axelo/custom-cpu/README.md

# custom-cpu

A custom CPU built from 7400-series integrated circuits.
