axelo/custom-cpu/kicad/custom-cpu.kicad_pcb

## KiCad design kicad/custom-cpu.kicad_pcb (2024-03-03)

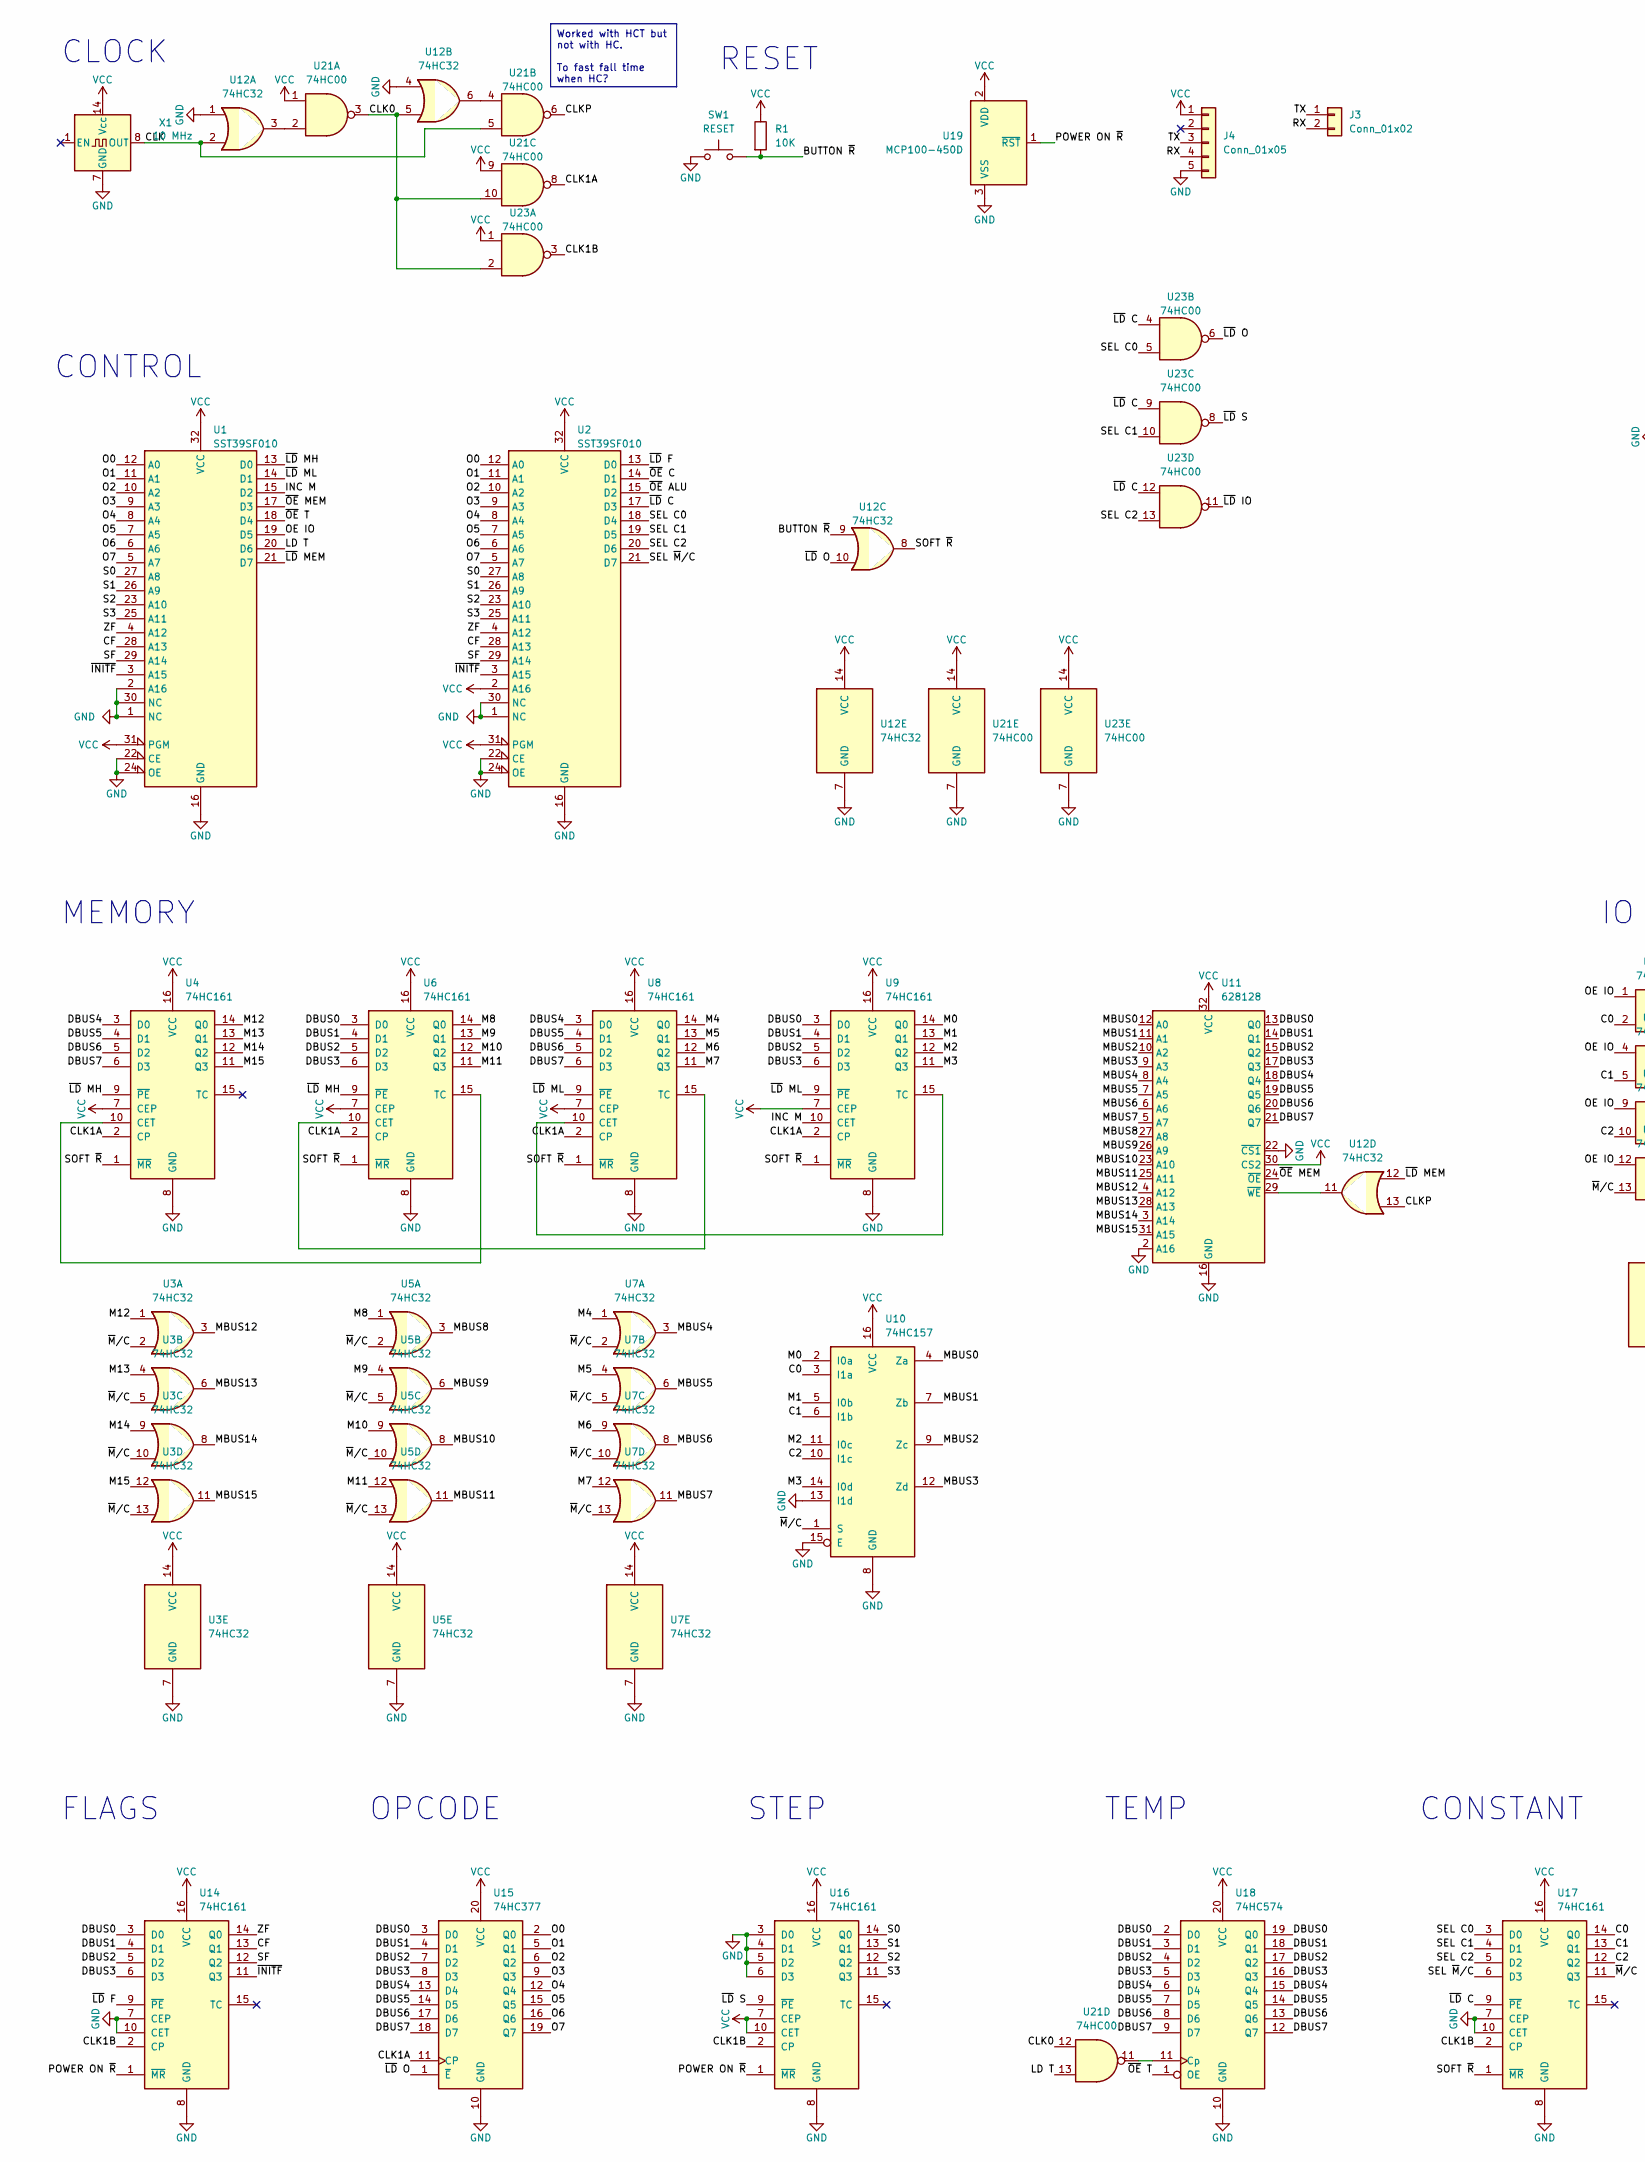
[picture p1: schematic custom-cpu.kicad_sch, part in row 1, column 1]

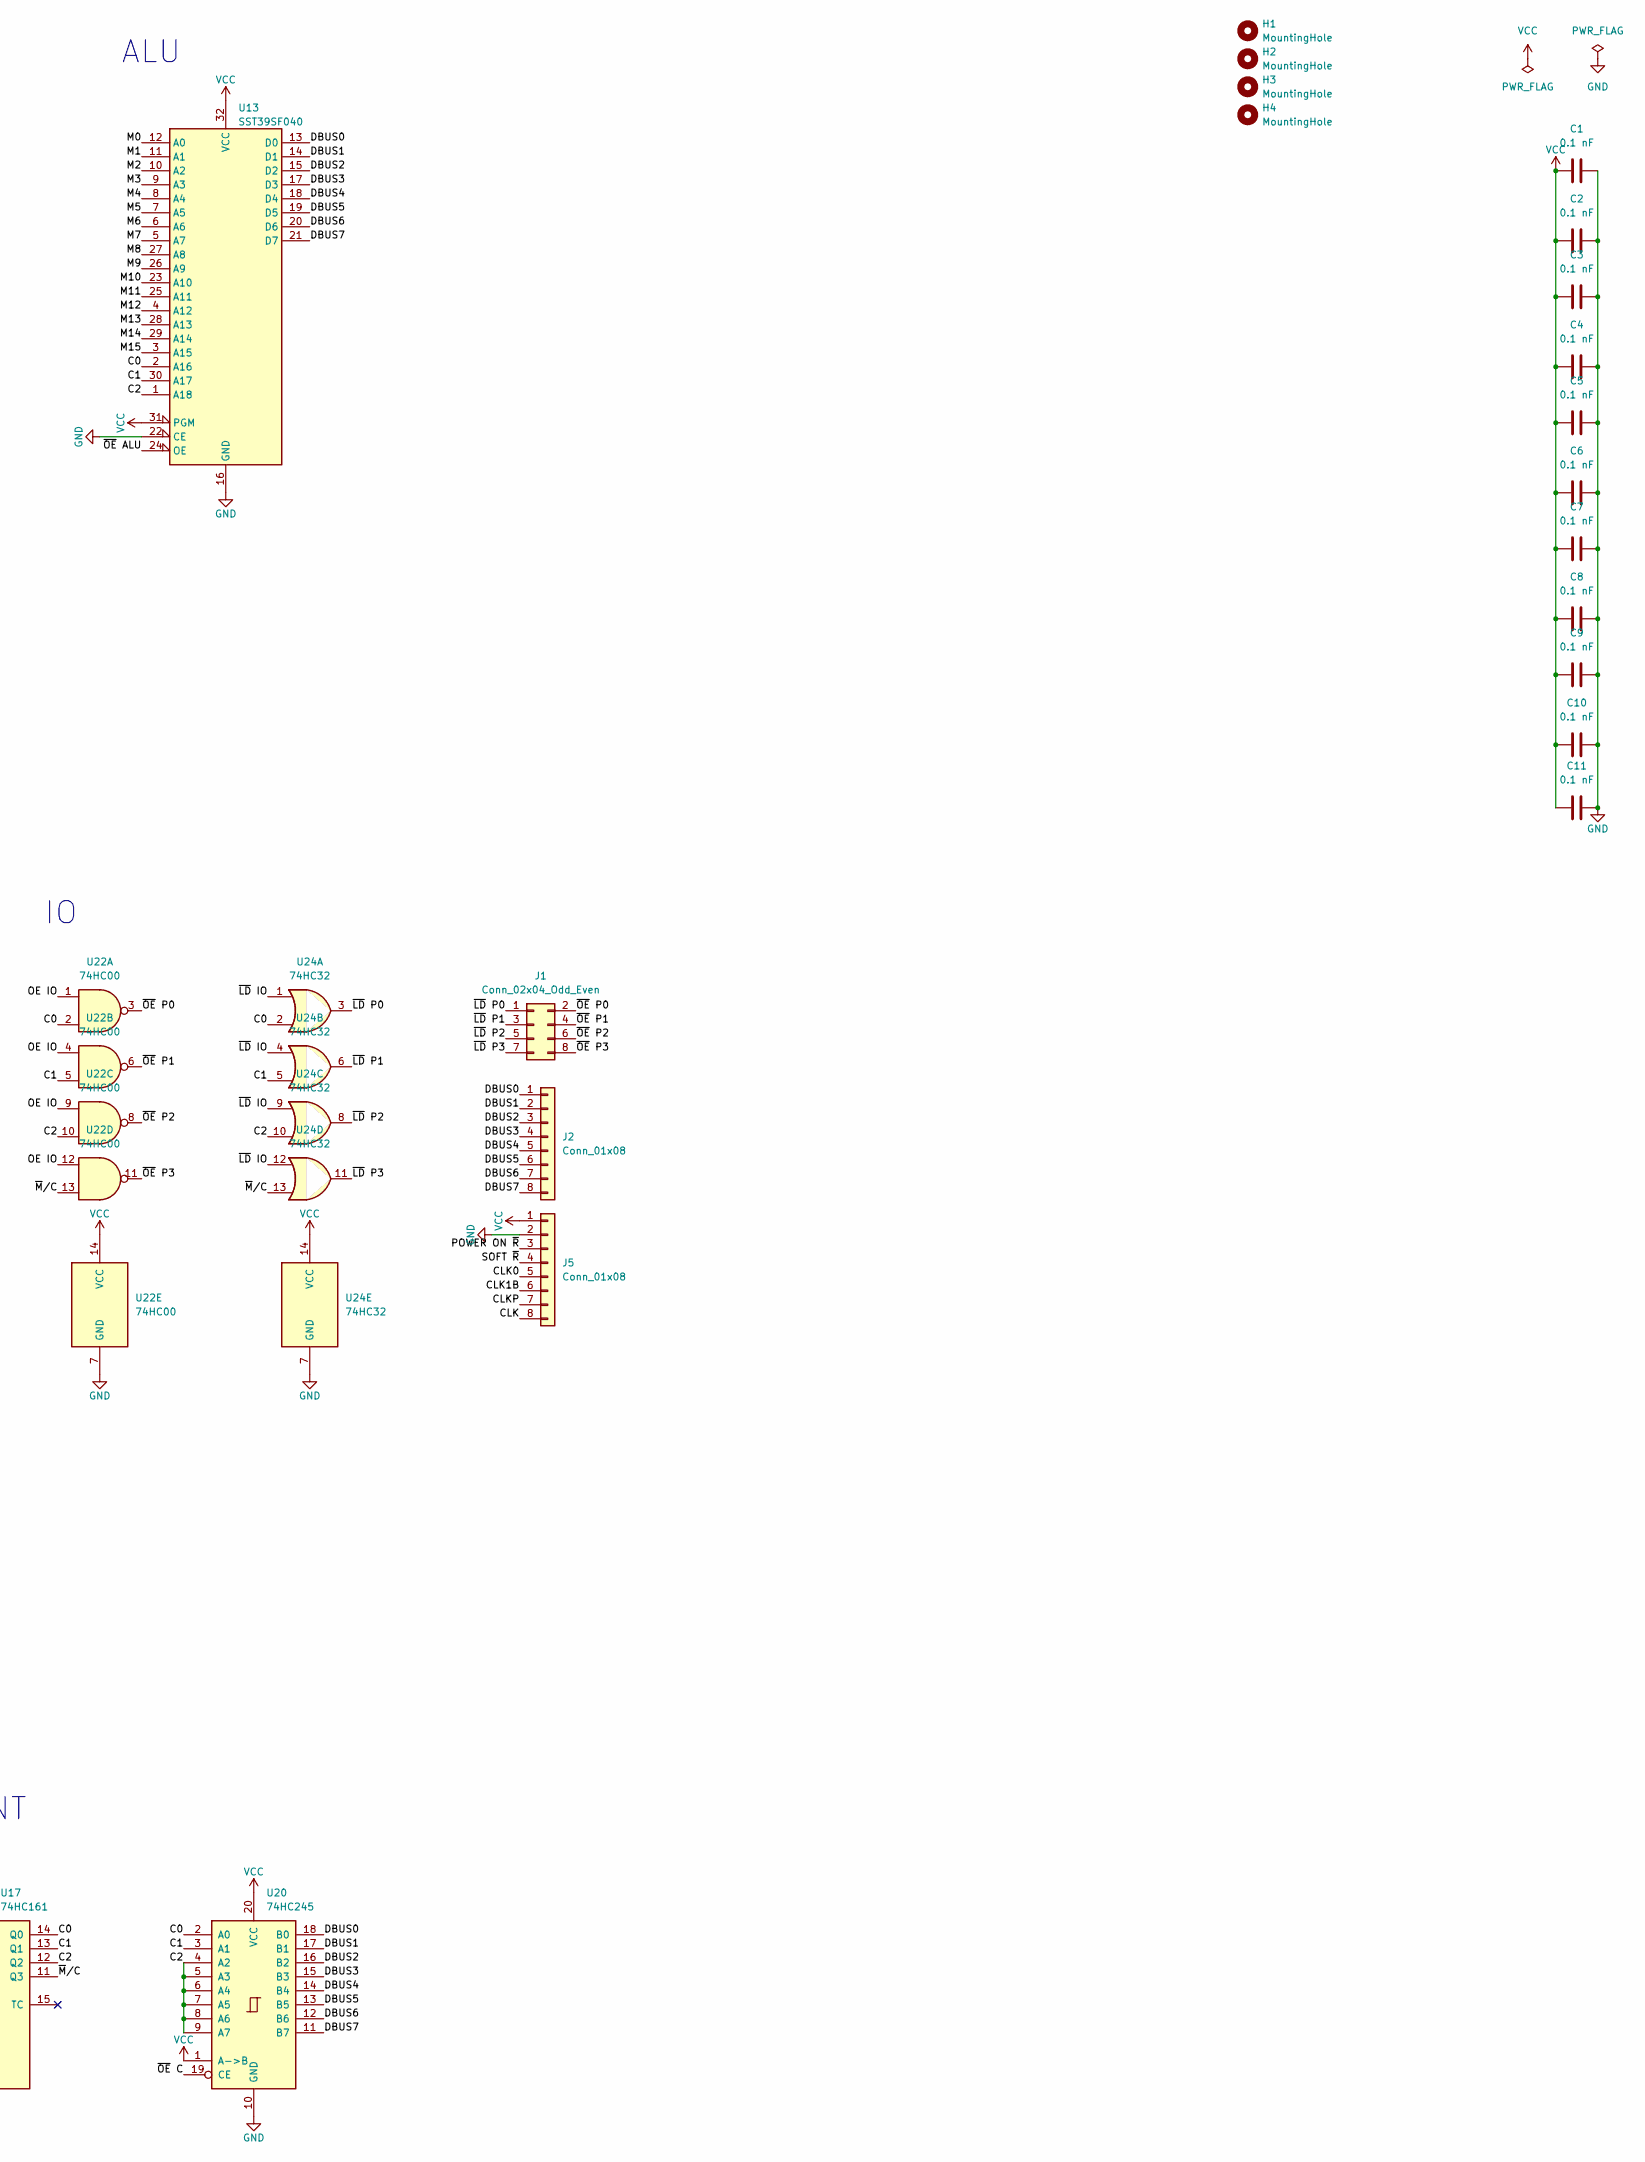
[picture p2: schematic custom-cpu.kicad_sch, part in row 1, column 2]

Parts:
C1, C2, C3, C4, C5, C6, C7, C8, C9, C10, C11: 0.1 nF; C_Disc_D5.0mm_W2.5mm_P5.00mm
H1, H2, H3, H4: MountingHole; MountingHole_3.2mm_M3
J1: Conn_02x04_Odd_Even; PinSocket_2x04_P2.54mm_Vertical
J2, J5: Conn_01x08; PinSocket_1x08_P2.54mm_Vertical
J3: Conn_01x02; PinSocket_1x02_P2.54mm_Vertical
J4: Conn_01x05; PinSocket_1x05_P2.54mm_Vertical
R1: 10K; R_Axial_DIN0207_L6.3mm_D2.5mm_P7.62mm_Horizontal
SW1: RESET; SW_PUSH_6mm
U1, U2: SST39SF010; DIP-32_W15.24mm_Socket
U3, U5, U7, U12, U24: 74HC32; DIP-14_W7.62mm_Socket
U4, U6, U8, U9, U14, U16, U17: 74HC161; DIP-16_W7.62mm_Socket
U10: 74HC157; DIP-16_W7.62mm_Socket
U11: 628128; DIP-32_W15.24mm_Socket
U13: SST39SF040; DIP-32_W15.24mm_Socket
U15: 74HC377; DIP-20_W7.62mm_Socket
U18: 74HC574; DIP-20_W7.62mm_Socket
U19: MCP100-450D; PinHeader_1x03_P2.00mm_Vertical
U20: 74HC245; DIP-20_W7.62mm_Socket
U21, U22, U23: 74HC00; DIP-14_W7.62mm_Socket
X1: 10 MHz; Oscillator_DIP-14

Connections:
/BUTTON ~R: R1.2, SW1.2, U12.9
/C0: U10.3 (I1a), U13.2 (A16), U17.14 (Q0), U20.2 (A0), U22.2, U24.2
/C1: U10.6 (I1b), U13.30 (A17), U17.13 (Q1), U20.3 (A1), U22.5, U24.5
/C2: U10.10 (I1c), U13.1 (A18), U17.12 (Q2), U20.4 (A2), U20.5 (A3), U20.6 (A4), U20.7 (A5), U20.8 (A6), U20.9 (A7), U22.10, U24.10
/CF: U1.28 (A13), U2.28 (A13), U14.13 (Q1)
/CLK: J5.8, U12.2, U21.5, X1.8 (OUT)
/CLK0: J5.5, U12.5, U21.3, U21.10, U21.12, U23.2
/CLK1A: U4.2 (CP), U6.2 (CP), U8.2 (CP), U9.2 (CP), U15.11 (CP), U21.8
/CLK1B: J5.6, U14.2 (CP), U16.2 (CP), U17.2 (CP), U23.3
/CLKP: J5.7, U12.13, U21.6
/DBUS0: J2.1, U6.3 (D0), U9.3 (D0), U11.13 (Q0), U13.13 (D0), U14.3 (D0), U15.3 (D0), U18.2 (D0), U18.19 (Q0), U20.18 (B0)
/DBUS1: J2.2, U6.4 (D1), U9.4 (D1), U11.14 (Q1), U13.14 (D1), U14.4 (D1), U15.4 (D1), U18.3 (D1), U18.18 (Q1), U20.17 (B1)
/DBUS2: J2.3, U6.5 (D2), U9.5 (D2), U11.15 (Q2), U13.15 (D2), U14.5 (D2), U15.7 (D2), U18.4 (D2), U18.17 (Q2), U20.16 (B2)
/DBUS3: J2.4, U6.6 (D3), U9.6 (D3), U11.17 (Q3), U13.17 (D3), U14.6 (D3), U15.8 (D3), U18.5 (D3), U18.16 (Q3), U20.15 (B3)
/DBUS4: J2.5, U4.3 (D0), U8.3 (D0), U11.18 (Q4), U13.18 (D4), U15.13 (D4), U18.6 (D4), U18.15 (Q4), U20.14 (B4)
/DBUS5: J2.6, U4.4 (D1), U8.4 (D1), U11.19 (Q5), U13.19 (D5), U15.14 (D5), U18.7 (D5), U18.14 (Q5), U20.13 (B5)
/DBUS6: J2.7, U4.5 (D2), U8.5 (D2), U11.20 (Q6), U13.20 (D6), U15.17 (D6), U18.8 (D6), U18.13 (Q6), U20.12 (B6)
/DBUS7: J2.8, U4.6 (D3), U8.6 (D3), U11.21 (Q7), U13.21 (D7), U15.18 (D7), U18.9 (D7), U18.12 (Q7), U20.11 (B7)
/INC M: U1.15 (D2), U9.10 (CET)
/LD T: U1.20 (D6), U21.13
/M0: U9.14 (Q0), U10.2 (I0a), U13.12 (A0)
/M1: U9.13 (Q1), U10.5 (I0b), U13.11 (A1)
/M2: U9.12 (Q2), U10.11 (I0c), U13.10 (A2)
/M3: U9.11 (Q3), U10.14 (I0d), U13.9 (A3)
/M4: U7.1, U8.14 (Q0), U13.8 (A4)
/M5: U7.4, U8.13 (Q1), U13.7 (A5)
/M6: U7.9, U8.12 (Q2), U13.6 (A6)
/M7: U7.12, U8.11 (Q3), U13.5 (A7)
/M8: U5.1, U6.14 (Q0), U13.27 (A8)
/M9: U5.4, U6.13 (Q1), U13.26 (A9)
/M10: U5.9, U6.12 (Q2), U13.23 (A10)
/M11: U5.12, U6.11 (Q3), U13.25 (A11)
/M12: U3.1, U4.14 (Q0), U13.4 (A12)
/M13: U3.4, U4.13 (Q1), U13.28 (A13)
/M14: U3.9, U4.12 (Q2), U13.29 (A14)
/M15: U3.12, U4.11 (Q3), U13.3 (A15)
/MBUS0: U10.4 (Za), U11.12 (A0)
/MBUS1: U10.7 (Zb), U11.11 (A1)
/MBUS2: U10.9 (Zc), U11.10 (A2)
/MBUS3: U10.12 (Zd), U11.9 (A3)
/MBUS4: U7.3, U11.8 (A4)
/MBUS5: U7.6, U11.7 (A5)
/MBUS6: U7.8, U11.6 (A6)
/MBUS7: U7.11, U11.5 (A7)
/MBUS8: U5.3, U11.27 (A8)
/MBUS9: U5.6, U11.26 (A9)
/MBUS10: U5.8, U11.23 (A10)
/MBUS11: U5.11, U11.25 (A11)
/MBUS12: U3.3, U11.4 (A12)
/MBUS13: U3.6, U11.28 (A13)
/MBUS14: U3.8, U11.3 (A14)
/MBUS15: U3.11, U11.31 (A15)
/O0: U1.12 (A0), U2.12 (A0), U15.2 (Q0)
/O1: U1.11 (A1), U2.11 (A1), U15.5 (Q1)
/O2: U1.10 (A2), U2.10 (A2), U15.6 (Q2)
/O3: U1.9 (A3), U2.9 (A3), U15.9 (Q3)
/O4: U1.8 (A4), U2.8 (A4), U15.12 (Q4)
/O5: U1.7 (A5), U2.7 (A5), U15.15 (Q5)
/O6: U1.6 (A6), U2.6 (A6), U15.16 (Q6)
/O7: U1.5 (A7), U2.5 (A7), U15.19 (Q7)
/OE IO: U1.19 (D5), U22.1, U22.4, U22.9, U22.12
/POWER ON ~R: J5.3, U14.1 (~MR), U16.1 (~MR), U19.1 (~RST)
/RX: J3.2, J4.4
/S0: U1.27 (A8), U2.27 (A8), U16.14 (Q0)
/S1: U1.26 (A9), U2.26 (A9), U16.13 (Q1)
/S2: U1.23 (A10), U2.23 (A10), U16.12 (Q2)
/S3: U1.25 (A11), U2.25 (A11), U16.11 (Q3)
/SEL C0: U2.18 (D4), U17.3 (D0), U23.5
/SEL C1: U2.19 (D5), U17.4 (D1), U23.10
/SEL C2: U2.20 (D6), U17.5 (D2), U23.13
/SEL ~M/C: U2.21 (D7), U17.6 (D3)
/SF: U1.29 (A14), U2.29 (A14), U14.12 (Q2)
/SOFT ~R: J5.4, U4.1 (~MR), U6.1 (~MR), U8.1 (~MR), U9.1 (~MR), U12.8, U17.1 (~MR)
/TX: J3.1, J4.3
/ZF: U1.4 (A12), U2.4 (A12), U14.14 (Q0)
/~INITF: U1.3 (A15), U2.3 (A15), U14.11 (Q3)
/~LD C: U2.17 (D3), U17.9 (~PE), U23.4, U23.9, U23.12
/~LD F: U2.13 (D0), U14.9 (~PE)
/~LD IO: U23.11, U24.1, U24.4, U24.9, U24.12
/~LD MEM: U1.21 (D7), U12.12
/~LD MH: U1.13 (D0), U4.9 (~PE), U6.9 (~PE)
/~LD ML: U1.14 (D1), U8.9 (~PE), U9.9 (~PE)
/~LD O: U12.10, U15.1 (~E), U23.6
/~LD P0: J1.1, U24.3
/~LD P1: J1.3, U24.6
/~LD P2: J1.5, U24.8
/~LD P3: J1.7, U24.11
/~LD S: U16.9 (~PE), U23.8
/~M/C: U3.2, U3.5, U3.10, U3.13, U5.2, U5.5, U5.10, U5.13, U7.2, U7.5, U7.10, U7.13, U10.1 (S), U17.11 (Q3), U22.13, U24.13
/~OE ALU: U2.15 (D2), U13.24 (OE)
/~OE C: U2.14 (D1), U20.19 (CE)
/~OE MEM: U1.17 (D3), U11.24 (~OE)
/~OE P0: J1.2, U22.3
/~OE P1: J1.4, U22.6
/~OE P2: J1.6, U22.8
/~OE P3: J1.8, U22.11
/~OE T: U1.18 (D4), U18.1 (OE)
GND: C1.2, C2.2, C3.2, C4.2, C5.2, C6.2, C7.2, C8.2, C9.2, C10.2, C11.2, J4.5, J5.2, SW1.1, U1.1 (NC), U1.2 (A16), U1.16 (GND), U1.22 (CE), U1.24 (OE), U1.30 (NC), U2.1 (NC), U2.16 (GND), U2.22 (CE), U2.24 (OE), U2.30 (NC), U3.7 (GND), U4.8 (GND), U5.7 (GND), U6.8 (GND), U7.7 (GND), U8.8 (GND), U9.8 (GND), U10.8 (GND), U10.13 (I1d), U10.15 (E), U11.2 (A16), U11.16 (GND), U11.22 (~CS1), U12.1, U12.4, U12.7 (GND), U13.16 (GND), U13.22 (CE), U14.7 (CEP), U14.8 (GND), U14.10 (CET), U15.10 (GND), U16.3 (D0), U16.4 (D1), U16.5 (D2), U16.6 (D3), U16.8 (GND), U17.7 (CEP), U17.8 (GND), U17.10 (CET), U18.10 (GND), U19.3 (VSS), U20.10 (GND), U21.7 (GND), U22.7 (GND), U23.7 (GND), U24.7 (GND), X1.7 (GND)
unnamed: U4.10 (CET), U6.15 (TC)
unnamed: U6.10 (CET), U8.15 (TC)
unnamed: U8.10 (CET), U9.15 (TC)
unnamed: U11.29 (~WE), U12.11
unnamed: U12.3, U21.2
unnamed: U12.6, U21.4
unnamed: U18.11 (Cp), U21.11
VCC: C1.1, C2.1, C3.1, C4.1, C5.1, C6.1, C7.1, C8.1, C9.1, C10.1, C11.1, J4.1, J5.1, R1.1, U1.31 (PGM), U1.32 (VCC), U2.2 (A16), U2.31 (PGM), U2.32 (VCC), U3.14 (VCC), U4.7 (CEP), U4.16 (VCC), U5.14 (VCC), U6.7 (CEP), U6.16 (VCC), U7.14 (VCC), U8.7 (CEP), U8.16 (VCC), U9.7 (CEP), U9.16 (VCC), U10.16 (VCC), U11.30 (CS2), U11.32 (VCC), U12.14 (VCC), U13.31 (PGM), U13.32 (VCC), U14.16 (VCC), U15.20 (VCC), U16.7 (CEP), U16.10 (CET), U16.16 (VCC), U17.16 (VCC), U18.20 (VCC), U19.2 (VDD), U20.1 (A->B), U20.20 (VCC), U21.1, U21.9, U21.14 (VCC), U22.14 (VCC), U23.1, U23.14 (VCC), U24.14 (VCC), X1.14 (Vcc)

Notes on the sheet:
Worked with HCT but not with HC. To fast fall time when HC?
CONTROL
FLAGS
RESET
CONSTANT
OPCODE
CLOCK
STEP
ALU
MEMORY
TEMP

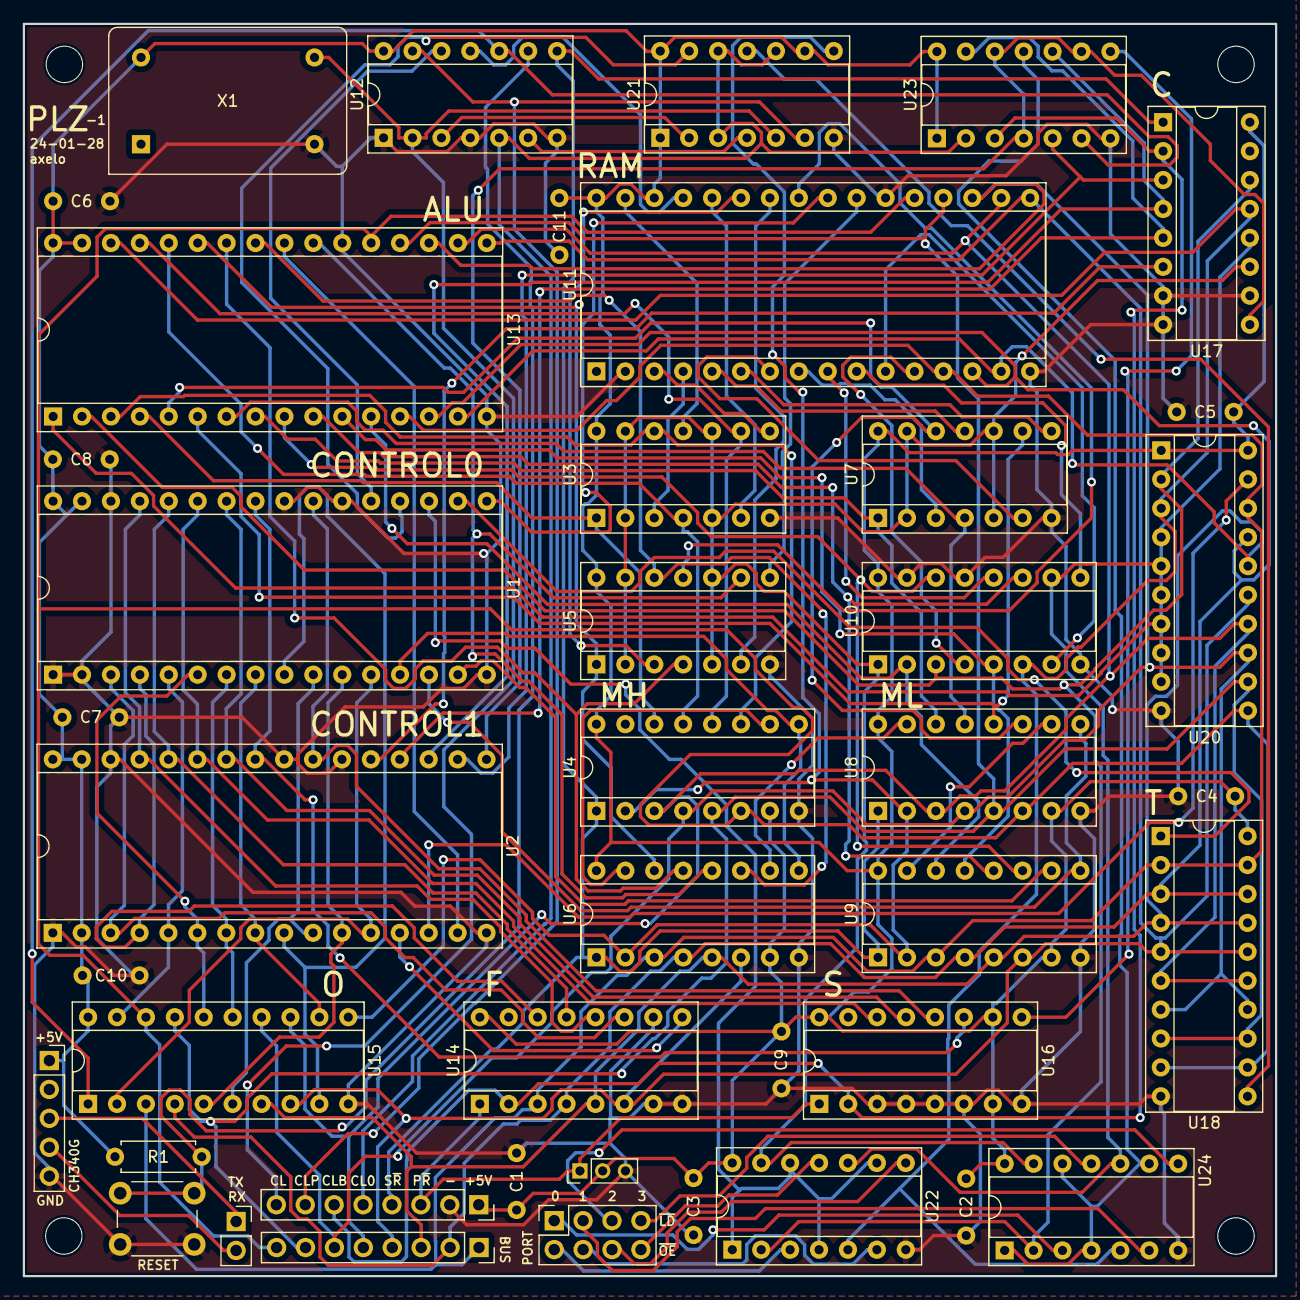
[picture p3: board custom-cpu.kicad_pcb from above]

Board: 2 copper layers, 110.0 x 110.0 mm, 47 parts (0 on the bottom side), 106 nets.
