axelo/custom-cpu/programs/gpo_sweep.asm

#include "../build/custom-cpu.inc"

; Program start
main:
    ld a, 0x1

.next:
    out 3, a

    ld b, 0
    ld c, 0
    ld d, 0
    ld e, 0
    .delay0: dec b
    jnz .delay0
    .delay1: dec b
    jnz .delay1
    .delay2: dec c
    jnz .delay2
    .delay3: dec d
    jnz .delay3
    .delay4: dec e
    jnz .delay4
    .delay5: dec b
    jnz .delay5
    .delay6: dec b
    jnz .delay6
    .delay7: dec c
    jnz .delay7
    .delay8: dec d
    jnz .delay8
    .delay9: dec e
    jnz .delay9
    .delay10: dec b
    jnz .delay10
    .delay11: dec b
    jnz .delay11
    .delay12: dec c
    jnz .delay12
    .delay13: dec d
    jnz .delay13
    .delay14: dec e
    jnz .delay14
    .delay15: dec b
    jnz .delay15
    .delay16: dec b
    jnz .delay16
    .delay17: dec c
    jnz .delay17
    .delay18: dec d
    jnz .delay18
    .delay19: dec e
    jnz .delay19
    .delay20: dec b
    jnz .delay20
    .delay21: dec b
    jnz .delay21
    .delay22: dec c
    jnz .delay22
    .delay23: dec d
    jnz .delay23
    .delay24: dec e
    jnz .delay24
    .delay25: dec b
    jnz .delay25
    .delay26: dec b
    jnz .delay26
    .delay27: dec c
    jnz .delay27
    .delay28: dec d
    jnz .delay28
    .delay29: dec e
    jnz .delay29
    .delay30: dec b
    jnz .delay30
    .delay31: dec b
    jnz .delay31
    .delay32: dec c
    jnz .delay32
    .delay33: dec d
    jnz .delay33
    .delay34: dec e
    jnz .delay34
    .delay35: dec b
    jnz .delay35
    .delay36: dec b
    jnz .delay36
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
    jnz .delayb63
    .delayb64: dec e
    jnz .delayb64
    .delayb65: dec b
    jnz .delayb65
    .delayb66: dec b
    jnz .delayb66
    .delayb67: dec c
    jnz .delayb67
    .delayb68: dec d
    jnz .delayb68
    .delayb69: dec e
    jnz .delayb69
    .delayb70: dec b
    jnz .delayb70
    .delayb71: dec b
    jnz .delayb71
    .delayb72: dec c
    jnz .delayb72
    .delayb73: dec d
    jnz .delayb73
    .delayb74: dec e
    jnz .delayb74
    .delayb75: dec b
    jnz .delayb75
    .delayb76: dec b
    jnz .delayb76
    .delayb77: dec c
    jnz .delayb77
    .delayb78: dec d
    jnz .delayb78
    .delayb79: dec e
    jnz .delayb79
    .delayb80: dec b
    jnz .delayb80

    shr a
    jnc .next_right

    jmp main
