axelo/custom-cpu/(commit log)

2024-03-03 PLZ-1 (#1)
    [custom-cpu.kicad_pcb, custom-cpu.kicad_sch]
2024-03-18 non blocking uart read (#2)
